felixkuebler/HomeAutomation-Remote/(list of files, cad)

Other CAD files:
Hardware/Mechanics/CAD/ProjectTemplate.skp
Hardware/TestAssembly/CAD/TestAssembly.skp
