felixkuebler/HomeAutomation-Remote/Hardware/Electronics/CAD/Remote.kicad_pcb

## KiCad design Hardware/Electronics/CAD/Remote.kicad_pcb (2023-05-17)

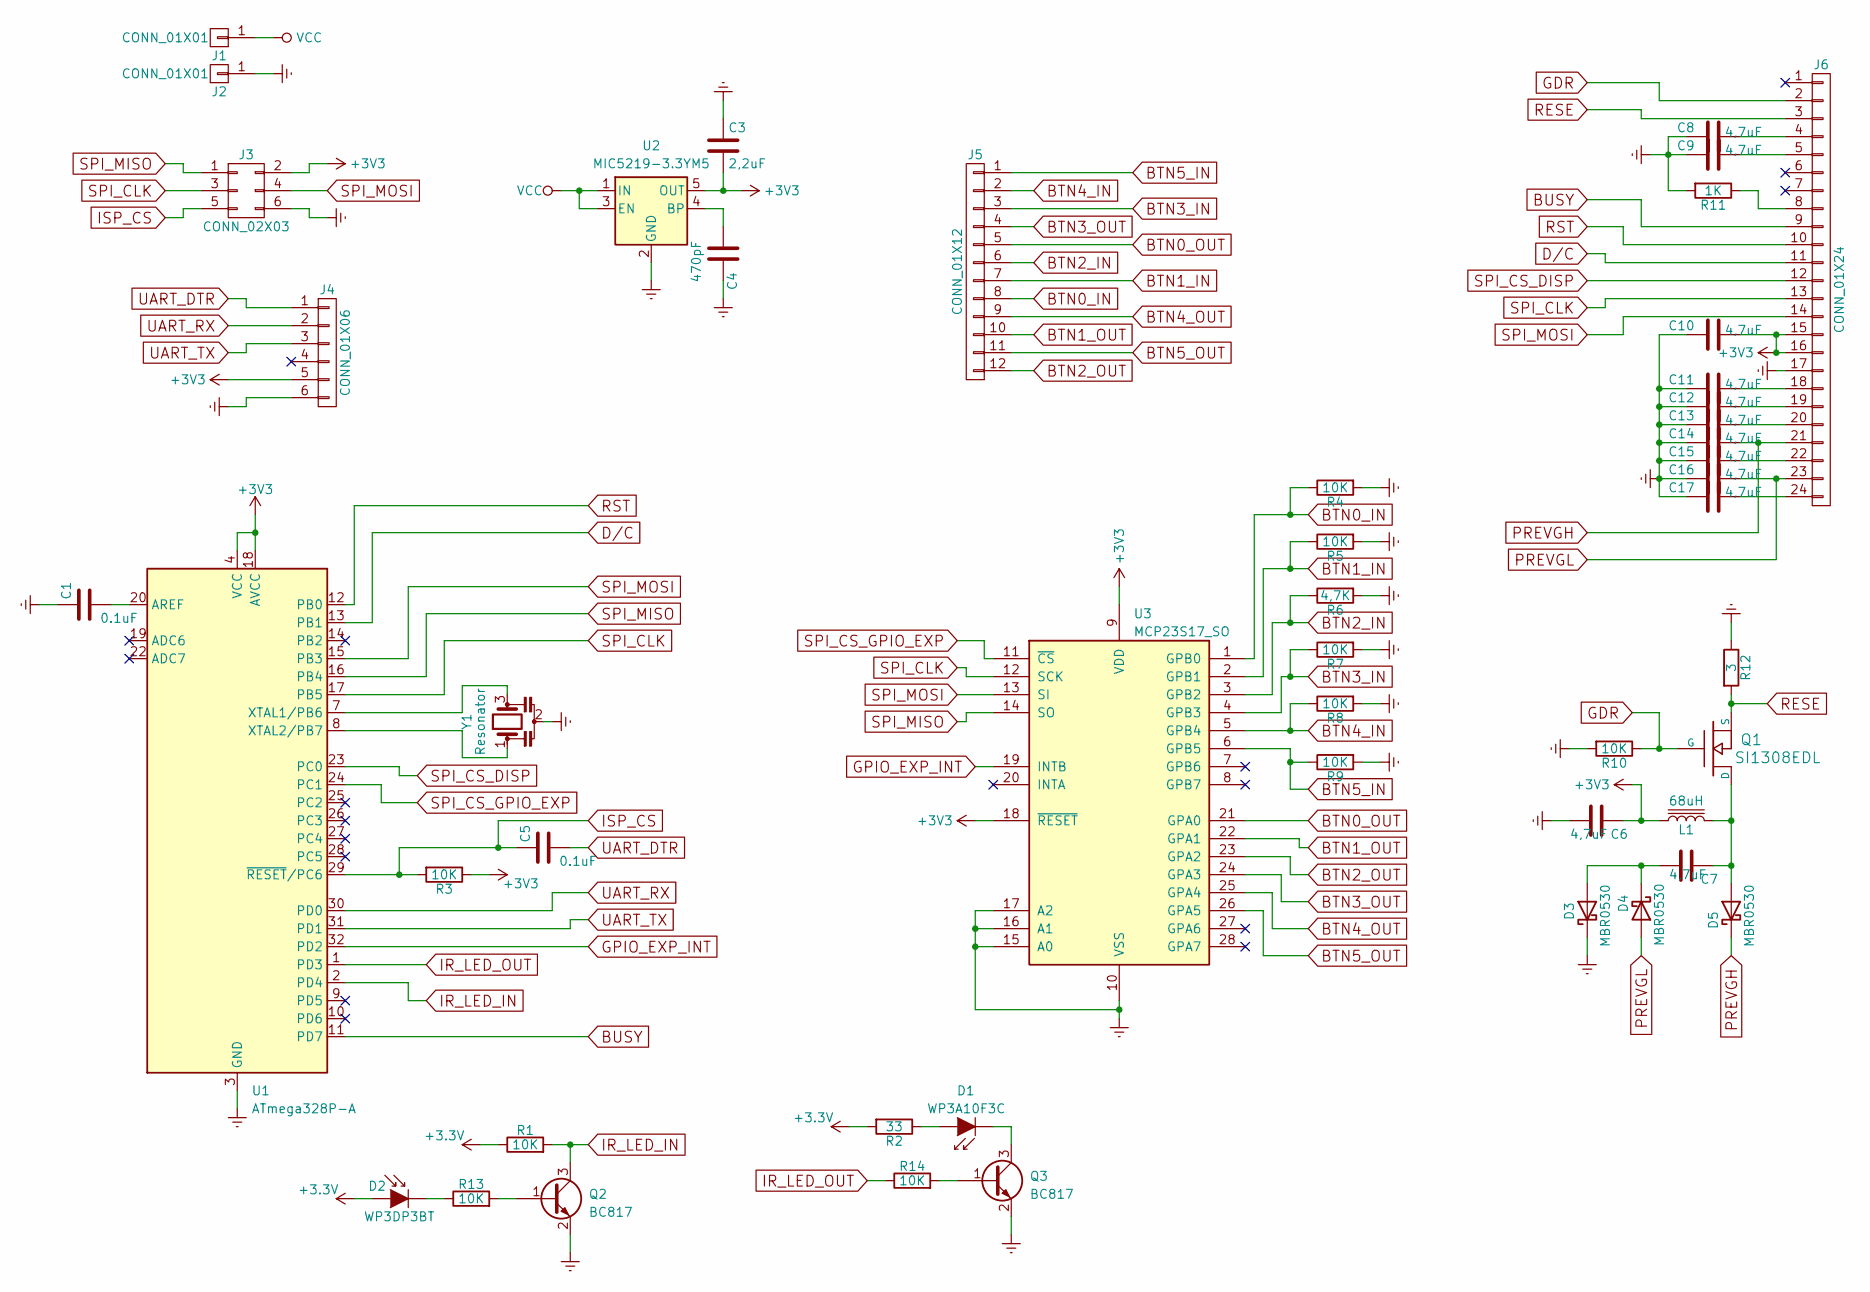
[picture p1: schematic Remote.kicad_sch, IOT Relay + Switch]

Parts:
C1, C5: 0.1uF; C_0805_2012Metric
C3: 2,2uF; C_0805_2012Metric
C4: 470pF; C_0805_2012Metric
C6, C7, C8, C9, C10, C11, C12, C13, C14, C15, C16, C17: 4,7uF; C_0805_2012Metric
D1: WP3A10F3C; LED_D3.0mm_Horizontal_O6.35mm_Z2.0mm
D2: WP3DP3BT; LED_D3.0mm_Horizontal_O6.35mm_Z2.0mm
D3, D4, D5: MBR0530; D_SOD-123
J1, J2: CONN_01X01; 1Pin
J3: CONN_02X03; PinHeader_2x03_P2.54mm_Vertical
J4: CONN_01X06; PinHeader_1x06_P2.54mm_Vertical
J5: CONN_01X12; SolderPad_1x12_1.27mm
J6: CONN_01X24; Hirose_FH12-24S-0.5SH_1x24-1MP_P0.50mm_Horizontal
L1: 68uH; L_1210_3225Metric
Q1: SI1308EDL; SOT-323_SC-70
Q2, Q3: BC817; SOT-23
R1, R3, R4, R5, R7, R8, R9, R10, R13, R14: 10K; R_0805_2012Metric
R2: 33; R_0805_2012Metric
R6: 4,7K; R_0805_2012Metric
R11: 1K; R_0805_2012Metric
R12: 3; R_0805_2012Metric
U1: ATmega328P-A; TQFP-32_7x7mm_P0.8mm
U2: MIC5219-3.3YM5; SOT-23-5
U3: MCP23S17_SO; SOIC-28W_7.5x17.9mm_P1.27mm
Y1: Resonator; Resonator_SMD_Murata_CSTxExxV-3Pin_3.0x1.1mm

Connections:
BTN0_IN: J5.8, R4.1, U3.1 (GPB0)
BTN0_OUT: J5.5, U3.21 (GPA0)
BTN1_IN: J5.7, R5.1, U3.2 (GPB1)
BTN1_OUT: J5.10, U3.22 (GPA1)
BTN2_IN: J5.6, R6.1, U3.3 (GPB2)
BTN2_OUT: J5.12, U3.23 (GPA2)
BTN3_IN: J5.3, R7.1, U3.4 (GPB3)
BTN3_OUT: J5.4, U3.24 (GPA3)
BTN4_IN: J5.2, R8.1, U3.5 (GPB4)
BTN4_OUT: J5.9, U3.25 (GPA4)
BTN5_IN: J5.1, R9.1, U3.6 (GPB5)
BTN5_OUT: J5.11, U3.26 (GPA5)
BUSY: J6.9, U1.11 (PD7)
D/C: J6.11, U1.13 (PB1)
Earth: C1.1, C3.1, C4.1, C6.2, C8.1, C9.1, C10.1, C11.1, C12.1, C13.1, C14.1, C15.1, C16.1, C17.1, D3.1 (K), J2.1, J3.6, J4.6, J6.17, Q2.2 (E), Q3.2 (E), R4.2, R5.2, R6.2, R7.2, R8.2, R9.2, R10.2, R11.2, R12.1, U1.3 (GND), U1.5 (GND), U1.21 (GND), U2.2 (GND), U3.10 (VSS), U3.15 (A0), U3.16 (A1), U3.17 (A2), Y1.2
GDR: J6.2, Q1.1 (G), R10.1
GPIO_EXP_INT: U1.32 (PD2), U3.19 (INTB)
IR_LED_IN: Q2.3 (C), R1.2, U1.2 (PD4)
IR_LED_OUT: R14.1, U1.1 (PD3)
ISP_CS: C5.1, J3.5, R3.2, U1.29 (~RESET/PC6)
unnamed: D1.2 (A), R2.1
unnamed: D1.1 (K), Q3.3 (C)
unnamed: D2.1 (K), R13.1
unnamed: C7.2, D3.2 (A), D4.1 (K)
unnamed: C7.1, D5.2 (A), L1.2, Q1.3 (D)
unnamed: C8.2, J6.4
unnamed: C9.2, J6.5
unnamed: J6.8, R11.1
unnamed: C11.2, J6.18
unnamed: C12.2, J6.19
unnamed: C13.2, J6.20
unnamed: C15.2, J6.22
unnamed: C17.2, J6.24
unnamed: Q2.1 (B), R13.2
unnamed: Q3.1 (B), R14.2
unnamed: C1.2, U1.20 (AREF)
unnamed: U1.7 (XTAL1/PB6), Y1.3
unnamed: U1.8 (XTAL2/PB7), Y1.1
unnamed: C4.2, U2.4 (BP)
PREVGH: C14.2, D5.1 (K), J6.21
PREVGL: C16.2, D4.2 (A), J6.23
RESE: J6.3, Q1.2 (S), R12.2
RST: J6.10, U1.12 (PB0)
SPI_CLK: J3.3, J6.13, U1.17 (PB5), U3.12 (SCK)
SPI_CS_DISP: J6.12, U1.23 (PC0)
SPI_CS_GPIO_EXP: U1.24 (PC1), U3.11 (~CS)
SPI_MISO: J3.1, U1.16 (PB4), U3.14 (SO)
SPI_MOSI: J3.4, J6.14, U1.15 (PB3), U3.13 (SI)
UART_DTR: C5.2, J4.1
UART_RX: J4.2, U1.30 (PD0)
UART_TX: J4.3, U1.31 (PD1)
VCC: J1.1, U2.1 (IN), U2.3 (EN)

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
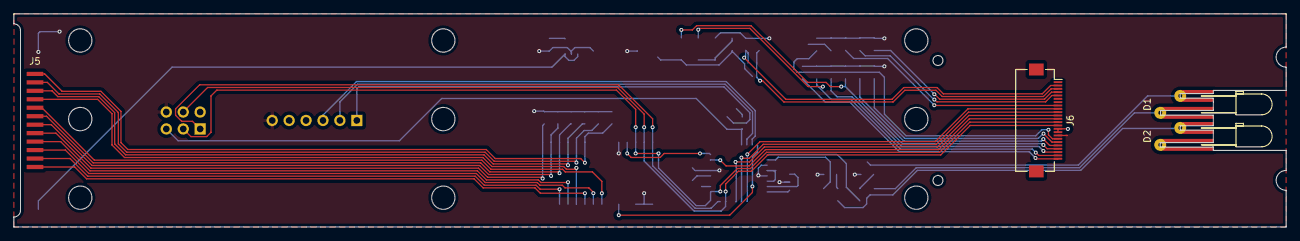
[picture p2: board Remote.kicad_pcb from above]

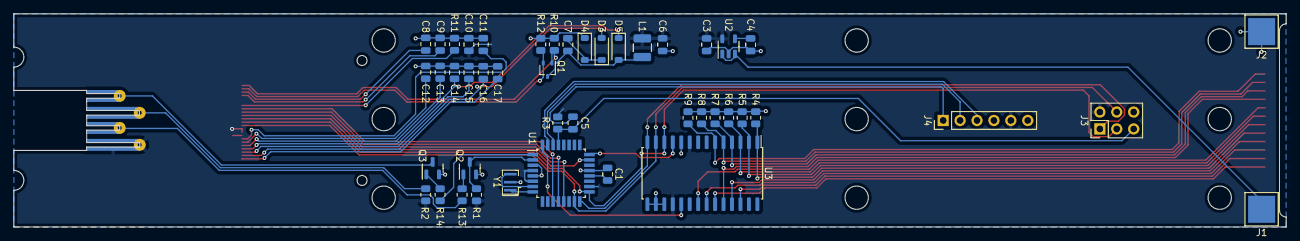
[picture p3: board Remote.kicad_pcb from below]

Board: 2 copper layers, 191.0 x 32.0 mm, 49 parts (45 on the bottom side), 53 nets.
