felixkuebler/HomeAutomation-Remote/Software/Source/RemoteController/IRConfig.hpp

#include <avr/pgmspace.h>

namespace IRConfig {

namespace IRCommands {

namespace Tv {

constexpr uint16_t tvOn[] PROGMEM = {
  4523,4523, 552,1683, 552,1683, 552,1683, 552,552, 552,552, 552,552, 552,552, 552,552, 552,1683,
  552,1683, 552,1683, 552,552, 552,552, 552,552, 552,552, 552,552, 552,1683, 552,552, 552,552, 552,1683,
  552,1683, 552,552, 552,552, 552,1683, 552,552, 552,1683, 552,1683, 552,552, 552,552, 552,1683,
  552,1683, 552,552, 552,43993
};
constexpr uint8_t tvOnLength = sizeof(tvOn)/sizeof(tvOn[0]);

constexpr uint16_t tvOff[] PROGMEM = {
  4523,4523, 552,1683, 552,1683, 552,1683, 552,552, 552,552, 552,552, 552,552, 552,552, 552,1683,
  552,1683, 552,1683, 552,552, 552,552, 552,552, 552,552, 552,552, 552,552, 552,552, 552,552, 552,1683,
  552,1683, 552,552, 552,552, 552,1683, 552,1683, 552,1683, 552,1683, 552,552, 552,552, 552,1683, 
  552,1683, 552,552, 552,43993
};
constexpr uint8_t tvOffLength = sizeof(tvOff)/sizeof(tvOff[0]);

constexpr uint16_t tvUp[] PROGMEM = {
  4480,4420, 580,1620, 580,1670, 530,1670, 580,520, 580,520, 580,520, 580,520, 580,520, 580,1670,
  530,1670, 580,1620, 580,520, 580,570, 530,570, 530,570, 580,520, 580,520, 580,520, 580,520, 580,570,
  530,570, 530,1670, 580,1620, 580,520, 580,1670, 530,1670, 580,1620, 580,1670, 530,1670, 580,520,
  580,520, 580,1620, 580
};
constexpr uint8_t tvUpLength = sizeof(tvUp)/sizeof(tvUp[0]);

constexpr uint16_t tvDown[] PROGMEM = {
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
  580,1620, 580,520, 580,520, 580,520, 580,1620, 630,470, 630,470, 630,1570, 630,470, 630,1620,
  580,1620, 580,1620, 580
};
constexpr uint8_t ampVolUpLength = sizeof(ampVolUp)/sizeof(ampVolUp[0]);

constexpr uint16_t ampVolDown[] PROGMEM = {
  8880,4420, 580,1620, 580,1620, 580,520, 580,520, 580,520, 580,520, 580,520, 580,1620, 630,1570,
  630,520, 580,470, 630,520, 580,1620, 580,520, 580,520, 580,520, 580,1620, 580,1620, 580,1620, 630,470,
  630,1570, 630,520, 580,520, 580,520, 580,520, 580,520, 580,520, 580,1620, 580,520, 580,1620,
  630,1570, 630,1570, 630
}; 
constexpr uint8_t ampVolDownLength = sizeof(ampVolDown)/sizeof(ampVolDown[0]);

};

};

};
