felixkuebler/HomeAutomation-Remote/(commit log)

2018-09-20 initial setup
    [Lichtschalter.skp]
2023-03-27 update design
    [Remote.kicad_pcb, Remote.sch]
2023-04-13 version 1.0 of remote schematics and pcb
    [Remote.kicad_pcb, Remote.kicad_sch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]
2023-04-13 add gerber files
    [Remote-B_Cu.gbl, Remote-B_Mask.gbs, Remote-B_Silkscreen.gbo, Remote-Edge_Cuts.gm1, Remote-F_Cu.gtl, Remote-F_Mask.gts, Remote-F_Silkscreen.gto, Remote-NPTH.drl]
2023-04-13 add 3d object for FFC connector
2023-05-15 remove old kicad project
    [B&O_remote_backup.sch, Remote.dsn, Remote.sch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]
2023-05-15 fix expander in schematics and pcb design
    [Remote.kicad_pcb, Remote.kicad_sch]
2023-05-15 Add MCP interrupthandling
2023-05-15 add display text feature and remove unnecessary display driver files
2023-05-15 Add deep sleep function to save power
2023-05-17 Change IR led resistor from 330 to 33 Ohm
    [Remote.kicad_pcb, Remote.kicad_sch]
2024-11-21 move gerber files to location outside of CAD
    [Remote-B_Cu.gbl, Remote-B_Mask.gbs, Remote-B_Silkscreen.gbo, Remote-Edge_Cuts.gm1, Remote-F_Cu.gtl, Remote-F_Mask.gts, Remote-F_Silkscreen.gto, Remote-NPTH.drl]
